BerlinUnited/embot/README.md

# embot
A simple controller kit for robotic experiments in embodyment. 

Some robots build by the students in our Embodied Robotics class:  
https://www.youtube.com/watch?v=9PvMIzAKYXQ
