BerlinUnited/embot/so2walker/readme.md

# BOM

## PCB mount

| Part  | Value  | Package | Description | Order |
|---|---|---|---|---|
| C1 | 100µF  | CPOL-EUE3.5-8 | Elko (Bulk) | Reichelt, M-A 100U 35 |
| C2 | 100nF  | C-EU025-025X050  | Keramik Cap | Reichelt, Z5U-2,5 100N |
| D1,D2 | | LED3MM | LED | - |
| R1,R2 | 1K | R-EU_0207/7 | Resistor | Reichelt, AG 04FTE52-1K |
| SW | | SWITCH-SPSTPTH | On/off Switch  | Reichelt, SS ESP101 |
| T1 | | TAC_SWITCHPTH | Tactile Switch | Reichelt, RND 210-00193 |
| P1-P4 | 10K | TRIMPOT_UNIV | Trimmerpotis | Reichelt, ACP 9-SRS 10K |
| M1-M4 | | PINHD 2.54mm | Pinheader 1x3  | Reichelt, MPE 087-1-003 |

Also needed:

* Arduino-Nano (or compatible)
* 2x Sockets 2.54 mm, 1X15, straight (if Arduino Nano shall not be permanently soldered)
* 2x Battery-Holder (e.g. Reichelt, HALTER 2XAAZ) + 4x AA Battery
* 4x Knob for Pots: e.g. Reichelt, ACHSE ACP 9 S
* 2-4x Micro-Servo: e.g. Conrad, 275460 - 62
