BerlinUnited/embot/so2walker/so2walker.brd.png

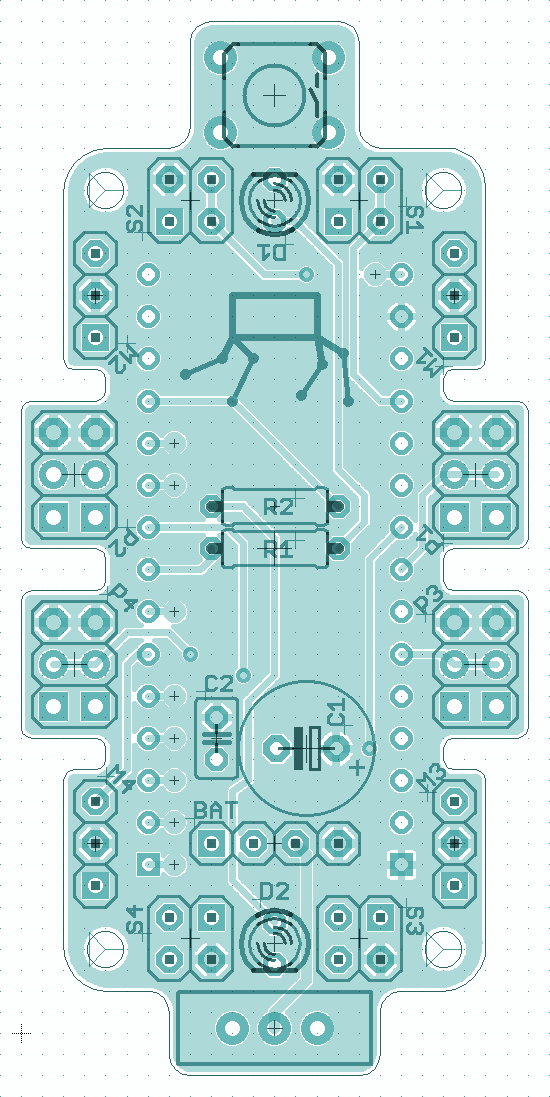
so2walker/so2walker.brd.png
