BerlinUnited/embot/so2walker/so2walker.sch.pdf

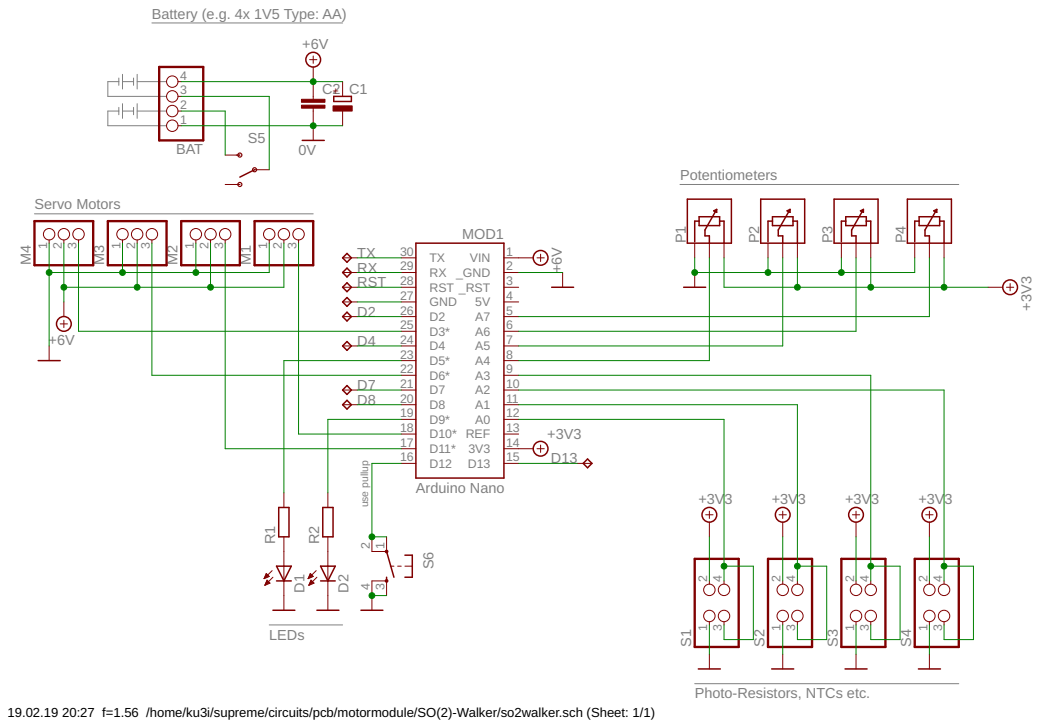
[picture p9: page 1]

use pullup Arduino Nano

Photo-Resistors, NTCs etc.

19.02.19 20:27 f=1.56 /home/ku3i/supreme/circuits/pcb/motormodule/SO(2)-Walker/so2walker.sch (Sheet: 1/1)
