BerlinUnited/embot/so2walker/so2walker.plc.pdf

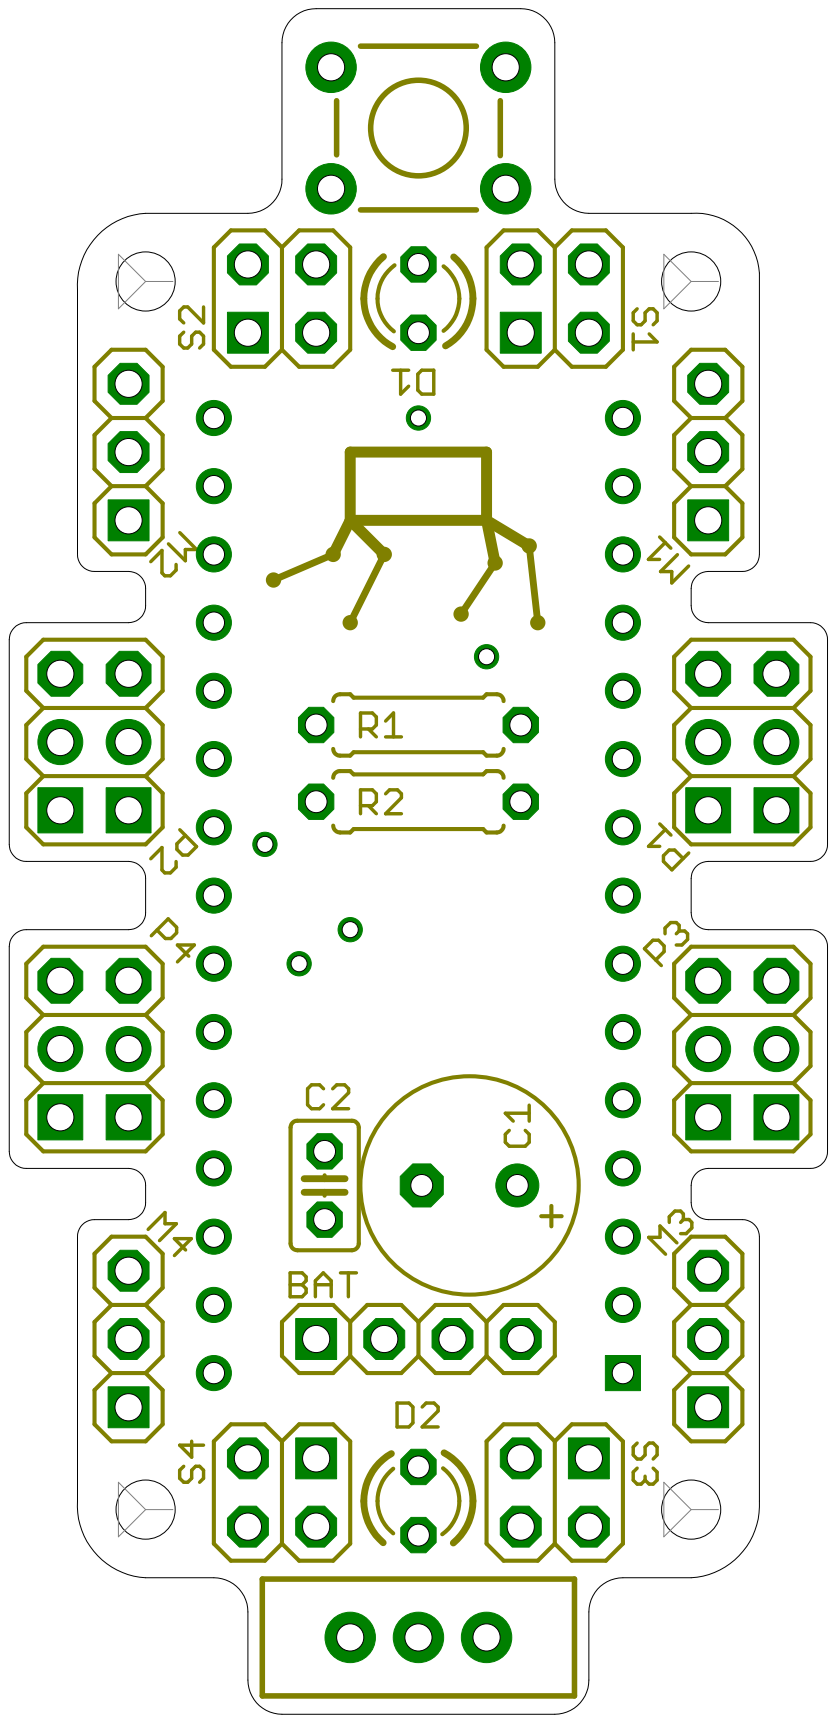
[picture p10: page 1]
