BerlinUnited/embot/so2walker/so2walker.brd

## EAGLE design so2walker/so2walker.brd (2019-02-19)

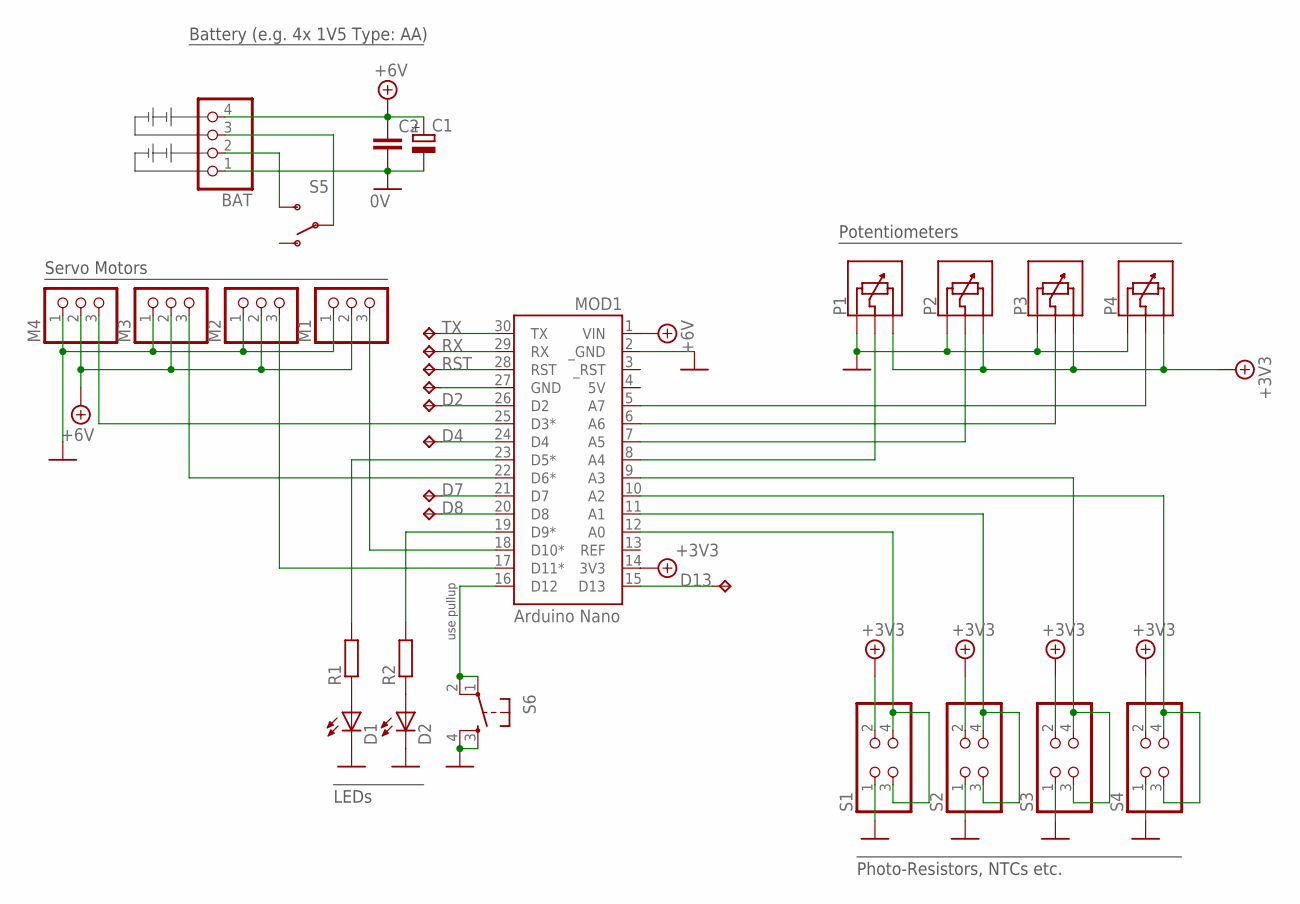
[picture p11: schematic so2walker.sch]

Parts:
BAT: PINHD-1X04_2.54-S; 1X04-S
C1: CPOL-EUE3.5-8; E3,5-8
C2: C-EU025-025X050; C025-025X050
D1, D2: LED3MM
M1, M2, M3, M4: PINHD-1X03_2.54-S; 1X03-S
MOD1: Arduino Nano; NANOSHLD_INV
P1, P2, P3, P4: TRIMPOT_UNIV; UNIPOT_DIL
R1, R2: R-EU_0207/7; 0207/7
S1, S2, S3, S4: PINHD-2X02_2.54; 2X02
S5: SWITCH-SPSTPTH; SWITCH-SPDT
S6: TAC_SWITCHPTH; TACTILE-PTH
TP1, TP2, TP3, TP4, TP5, TP6, TP7, TP8, TP10: TPB1,27; B1,27

Connections:
5V: MOD1.4 (5V)
+3V3: BAT.4, C1.+, C2.1, M1.2, M2.2, M3.2, M4.2, MOD1.1 (VIN), MOD1.14 (3V3), P1.3A, P1.3B, P2.3A, P2.3B, P3.3A, P3.3B, P4.3A, P4.3B, S1.2, S2.2, S3.2, S4.2
D2: MOD1.26 (D2), TP4.TP
D4: MOD1.24 (D4), TP5.TP
D7: MOD1.21 (D7), TP6.TP
D8: MOD1.20 (D8), TP7.TP
D12: MOD1.16 (D12), S6.1, S6.2
D13: MOD1.15 (D13), TP8.TP
GND: BAT.1, C1.-, C2.2, D1.K (C), D2.K (C), M1.1, M2.1, M3.1, M4.1, MOD1.2 (_GND), P1.1A, P1.1B, P2.1A, P2.1B, P3.1A, P3.1B, P4.1A, P4.1B, S1.1, S2.1, S3.1, S4.1, S6.3, S6.4
unnamed: MOD1.27 (GND), TP10.TP
unnamed: M2.3, MOD1.17 (D11*)
unnamed: M3.3, MOD1.22 (D6*)
unnamed: M4.3, MOD1.25 (D3*)
unnamed: MOD1.23 (D5*), R1.2
unnamed: MOD1.19 (D9*), R2.2
unnamed: MOD1.8 (A4), P1.2A, P1.2B
unnamed: MOD1.7 (A5), P2.2A, P2.2B
unnamed: MOD1.6 (A6), P3.2A, P3.2B
unnamed: BAT.3, S5.2
unnamed: BAT.2, S5.3 (S)
unnamed: MOD1.5 (A7), P4.2A, P4.2B
unnamed: MOD1.11 (A1), S2.3, S2.4
unnamed: MOD1.12 (A0), S1.3, S1.4
unnamed: MOD1.10 (A2), S4.3, S4.4
unnamed: MOD1.9 (A3), S3.3, S3.4
unnamed: D1.A, R1.1
unnamed: D2.A, R2.1
unnamed: M1.3, MOD1.18 (D10*)
REF: MOD1.13 (REF)
RST: MOD1.28 (RST), TP3.TP
RX: MOD1.29 (RX), TP2.TP
TX: MOD1.30 (TX), TP1.TP

Notes on the sheet:
Servo Motors
Potentiometers
Battery (e.g. 4x 1V5 Type: AA)
LEDs
Photo-Resistors, NTCs etc.
use pullup

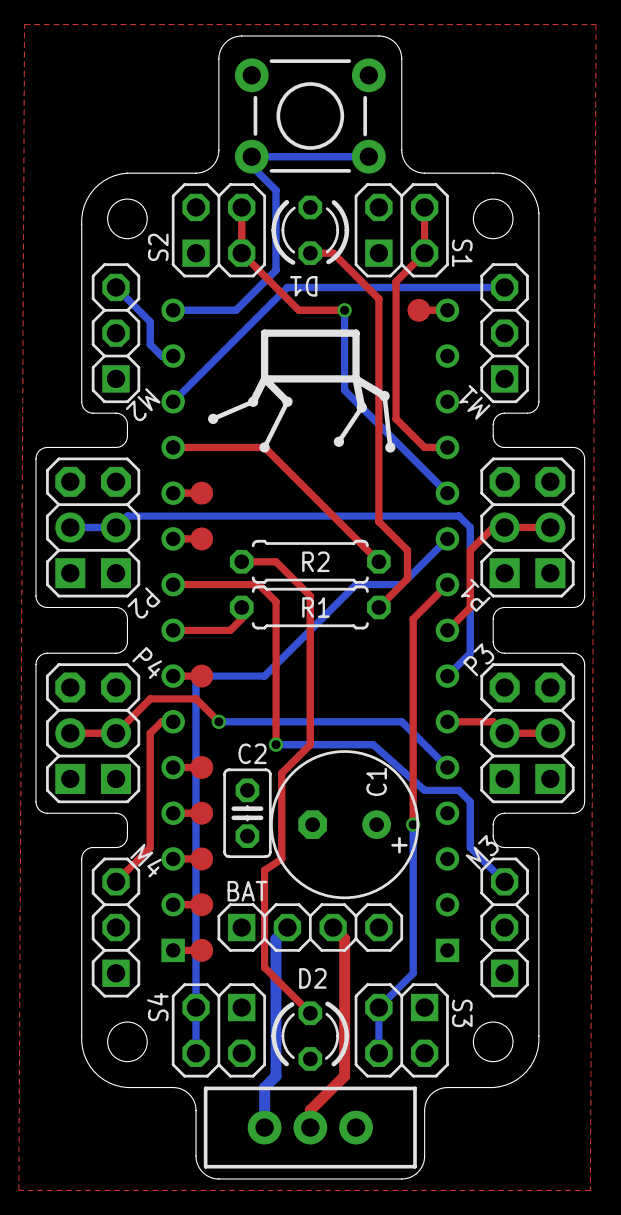
[picture p12: board so2walker.brd from above]

Board: 2 copper layers, 30.5 x 63.5 mm, 31 parts (0 on the bottom side), 30 nets.
