BerlinUnited/embot/(commit log)

2019-02-19 first version of the step by step instruction for making the test board
2019-02-19 Added alternative pcb version.
    [so2walker.brd, so2walker.sch]
2019-03-14 Fixed bug with swapped pins, added part values, simplified routing, added complete BOM.
